CodeJhon/Kreacher-A-RISC-V-based-SoC-Design/2_Core/src/3_EX/divider_top.v

// =============================================================================
// File        : divider_top.v
// Author      : Jhon Steven Pinto Hernandez
// Email       : jhonstevenpintoh@gmail.com
// Description :
//   Implements signed/unsigned division and remainder operations with quick-result detection and pause signaling.
// =============================================================================

`include "../../include/CORE_CONSTANTS.vh"

module divider_top #(parameter XLEN = 64)(
    //Global
    input clk,
    input reset_n,
    input pause,

    //Operands & Operation Type
    input signed [XLEN-1:0]      opa,
    input signed [XLEN-1:0]      opb,
    input [5:0]                  sel_operation,

    //Output Flags
    output reg                   pause_to_divide,   

    //Result
    output reg signed [XLEN-1:0] remainder_result,
    output reg signed [XLEN-1:0] quotient_result
);

//Obtaining the lower part in the _W type instructions
reg signed [XLEN-1:0] dividend;
reg signed [XLEN-1:0] divisor;
always @( * ) begin
    case (sel_operation)
        `ALU_DIVW, `ALU_REMW: begin
            dividend = $signed(opa[31:0]);    // sign-extend
            divisor  = $signed(opb[31:0]);
        end
        `ALU_DIVUW, `ALU_REMUW: begin
            dividend = $unsigned(opa[31:0]);  // zero-extend
            divisor  = $unsigned(opb[31:0]);
        end
        default:begin
            dividend = opa;
            divisor  = opb;
        end
    endcase 
end

//Determining if operands are signed / unsigned -> Depending on the instruction
reg rs1_is_signed;
reg rs2_is_signed;
always @( * ) begin
    //Default values
    rs1_is_signed = 1'b0;
    rs2_is_signed = 1'b0;
    case (sel_operation)
        `ALU_DIV, `ALU_REM, `ALU_DIVW, `ALU_REMW:begin
            rs1_is_signed = 1'b1;
            rs2_is_signed = 1'b1;
        end
        `ALU_DIVU, `ALU_REMU, `ALU_DIVUW, `ALU_REMUW:begin //Unsigned
            rs1_is_signed = 1'b0;
            rs2_is_signed = 1'b0;
        end
    endcase
end

// Obtaining the absolute value of dividend & divisor -> For quick-result cases
wire a_neg = rs1_is_signed & dividend[XLEN-1];
wire b_neg = rs2_is_signed & divisor[XLEN-1];

wire  [XLEN-1:0] dividend_abs = a_neg ? (~dividend + 64'd1) : dividend;
wire  [XLEN-1:0] divisor_abs  = b_neg ? (~divisor  + 64'd1) : divisor;

//Quick-Result cases: Allow us to throw a result in the same cycle and not use the dedicated divider module
// Cases: Divide by zero, divisor greater than divider, divide by same number ...busy
reg flag_result_one;
reg flag_division_by_zero;
reg flag_result_zero;

wire flag_quick_result =    flag_result_one         |
                            flag_division_by_zero   |
                            flag_result_zero;

always @( * ) begin
    flag_division_by_zero  = 1'b0;
    flag_result_zero       = 1'b0;
    flag_result_one        = 1'b0;

    if(divisor == {XLEN{1'b0}})
        flag_division_by_zero = 1'b1;
    else if((dividend == {XLEN{1'b0}}) || (divisor_abs > dividend_abs))
        flag_result_zero      = 1'b1;
    else if(divisor_abs == dividend_abs)
        flag_result_one       = 1'b1;
end

//Start signal
reg start;
always @( * ) begin
    start = 1'b0;
    if(!flag_quick_result)begin
        case (sel_operation)
            `ALU_DIV   , `ALU_REM,
            `ALU_DIVU  , `ALU_REMU,
            `ALU_DIVW  , `ALU_REMW,
            `ALU_DIVUW , `ALU_REMUW:
                start = 1'b1;
        endcase
    end
end

//Module containing the division algorithm (radix 4) hardware
wire busy;
wire done;
wire signed [XLEN-1:0]  remainder;
wire signed [XLEN-1:0]  quotient;
radix_4_divider #(.XLEN(64)) radix_4_divider_inst (
    //Global
    .clk(clk),
    .reset_n(reset_n),
    .pause(pause),

    //Control
    .start(start),
    .rs1_is_signed(rs1_is_signed),
    .rs2_is_signed(rs2_is_signed),

    //Operands & Result
    .dividend($unsigned(dividend)),
    .divisor($unsigned(divisor)),

    .remainder(remainder),
    .quotient(quotient),

    //Output flags
    .busy(busy),
    .done(done)
);

//Output assignation

//Remainder result
always @( * ) begin
    //Default value
    remainder_result = remainder;

    //Quick-Result cases
    if(flag_division_by_zero)
            remainder_result = dividend;
    else if (flag_result_one)
            remainder_result = {XLEN{1'b0}};
    else if(flag_result_zero)
            remainder_result = dividend;
end

//Quotient result
wire instr_is_div_signed = (sel_operation == `ALU_DIV || sel_operation == `ALU_DIVW);
always @( * ) begin
    //Default value
    quotient_result = quotient;
    
    //------ Quick-Result cases-----

    //Division by zero
    if (flag_division_by_zero)
        quotient_result = {XLEN{1'b1}}; //Send FFFFFFFF_FFFFFFFF

    else if (flag_result_one)begin //Division by same magnitude
        if(dividend[XLEN-1] == divisor[XLEN-1]) // Same sign
            quotient_result = $signed(1);
        else
            quotient_result = $signed(-1); // Different sign
    end
    else if (flag_result_zero) // Division by 0 or by a/b (b>a)
            quotient_result = {XLEN{1'b0}};
end

//Pause signal
always @( * ) begin
    pause_to_divide = 1'b0;
    if(done)
        pause_to_divide = 1'b0;
    else if(start || busy)
        pause_to_divide = 1'b1;
end

endmodule
