CodeJhon/Kreacher-A-RISC-V-based-SoC-Design/3_Init_Memory_Controller/src/init_ctrl.v

// =============================================================================
// File        : init_ctrl.v
// Author      : Sanjai Palanisamy
// Email       : sanjai.palanisamy171@gmail.com
// Description :
//   This module implements the control FSM for memory initialization and normal memory 
// operations, managing address generation, instruction prefetch, and partial read/write 
// masking through appropriate control signals.
// =============================================================================

module init_ctrl #(
  parameter integer ADDR_W         = 17,         // PRAM address width
  parameter [ADDR_W-1:0] BASE_ADDR = 17'h00000,  // init start address
  parameter [ADDR_W-1:0] MEM_LIMIT = 17'h07FFF,   // MEM_LIMIT is an exclusive upper bound (init runs while addr < MEM_LIMIT)
  parameter [ADDR_W-1:0] INCR      = 17'd8
)(
  input  wire                 clk,
  input  wire                 reset_n,

  // -------------------------------------------------------------------------
  // Global control inputs
  // -------------------------------------------------------------------------
  input  wire                 interrupt,       // pause/abort during init
  input  wire                 enable,          // step address (one word)
  input  wire                 masking_enabled,
  input  wire                 partial_read_done,
  input  wire                 partial_write_done,

  // -------------------------------------------------------------------------
  // Encoded FSM state (visible to MemCtrl / top-level)
  // -------------------------------------------------------------------------
  output reg  [3:0]           state,           // 6-state encoding

  // -------------------------------------------------------------------------
  // Datapath control signals (match your control table)
  // -------------------------------------------------------------------------
  output reg  [1:0]           SPI_rdata_type,  // 0 = INITIALIZATION, 1 = EMBD_READ(load)
  output reg                  PRAM_addr_type,  // 0 = INITIALIZATION, 1 = LOAD/STORE ADDRESS
  output reg                  PRAM_in,         // 0 = INITIALIZATION, 1 = STORE DATA
  output reg                  burst_dim,       // 0 = INITIALIZATION, 1 = LOAD/STORE ADDRESS
  output reg                  ROM_addr_type,   // 0 = init read addr, 1 = EMAB(load/store)
  output reg                  mem_init,        // 1 = init phase (S_START/S_WAIT/S_PAUSE)
  output reg                  pre_fetch,
  output reg  [1:0]           write_enable_state,
  output reg                  write_state,
  // -------------------------------------------------------------------------
  // Address generated by internal counter
  // -------------------------------------------------------------------------
  output wire [ADDR_W-1:0]    INITIALIZATION_addr
);

  // -------------------------------------------------------------------------
  // Address counter instance
  // -------------------------------------------------------------------------
  wire [ADDR_W-1:0] count;
  reg mem_init_done;

  up_counter #(
    .INCR      (INCR),        // 8 bytes per word
    .LOAD_DIM  (ADDR_W),
    .COUNT_DIM (ADDR_W)
  ) up_counter_inst (
    .clk        (clk),
    .enable     (enable),
    .reset_n    (reset_n),
    .load_value (BASE_ADDR),
    .max_value  (MEM_LIMIT),
    .count      (count)
  );
  assign INITIALIZATION_addr = count;

  always @( * ) begin
  if (!reset_n)
    mem_init_done = 1'b0;
  else if (mem_init && enable && (INITIALIZATION_addr >= (MEM_LIMIT - INCR)))
    mem_init_done = 1'b1;
  else mem_init_done = 1'b0;
  end



  // -------------------------------------------------------------------------
  // FSM state encoding (4 states)
  // -------------------------------------------------------------------------
  localparam [3:0]
    S_IDLE               = 4'd0,  // after reset: go to S_START
    S_START              = 4'd1,  // first cycle of init
    S_WAIT               = 4'd2,  // wait for MemCtrl to finish
    S_FIRST_FETCH        = 4'd3,//to implement first fetch
    S_NORMAL_OP          = 4'd4,  // init success (terminal) and normal operation
    S_PARTIAL_READ       = 4'd5,
    S_APPLY_MASK         = 4'd6,
    S_PARTIAL_WRITE      = 4'd7,
    S_PARTIAL_STORE_DONE = 4'd8;

  reg [3:0] state_next;

  // ==========================================================================
  // State register
  // ==========================================================================
  always @(posedge clk, negedge reset_n) begin
    if (!reset_n)
      state <= S_IDLE;
    else
      state <= state_next;
  end

  // ==========================================================================
  // Next-state logic
  // ==========================================================================
  always @( * ) begin
    state_next = state;

    case (state)
      // After reset we always run external initialization
      S_IDLE: begin
        state_next = S_START;
      end

      // One init cycle, then wait for Memory Controller
      S_START: begin
        state_next = S_WAIT;
      end

      // Normal init in progress
      S_WAIT: begin
        if (mem_init_done || interrupt)
          state_next = S_FIRST_FETCH;
        else
          state_next = S_WAIT;
      end

      //first instruction fetch
      S_FIRST_FETCH: begin
        state_next = S_NORMAL_OP;
      end

      // Terminal states: stay here until global reset
      S_NORMAL_OP: begin
        if(masking_enabled)begin
          state_next = S_PARTIAL_READ;
        end
        else begin
          state_next = S_NORMAL_OP;
        end
      end

      S_PARTIAL_READ: begin
        if(partial_read_done)state_next = S_APPLY_MASK;
        else state_next = S_PARTIAL_READ;
      end

      S_APPLY_MASK: begin
        state_next = S_PARTIAL_WRITE;
      end
      
      S_PARTIAL_WRITE:begin
        //should add
        if(partial_write_done)  state_next = S_PARTIAL_STORE_DONE; 
        else state_next = S_PARTIAL_WRITE;
      end

      S_PARTIAL_STORE_DONE:begin
        state_next = S_NORMAL_OP;
      end
      default: state_next = S_IDLE;
    endcase
  end

  // ==========================================================================
  // Output control logic
  //   Default = load/store mode (green in your diagram).
  // ==========================================================================
  always @( * ) begin
    // ----- defaults: normal load/store mode -----
    mem_init       = 1'b0;
    SPI_rdata_type = 2'b01;   // 1 = EMBD_READ(load)
    PRAM_addr_type = 1'b1;   // 1 = LOAD/STORE address
    PRAM_in        = 1'b1;   // 1 = STORE data
    burst_dim      = 1'b1;   // 1 = LOAD/STORE
    ROM_addr_type  = 1'b1;   // 1 = EMAB(load/store address)
    pre_fetch    = 1'b0;
    write_enable_state = 2'b00;
    write_state    = 1'b0;

    case (state)
      // Initialization states
      S_START, S_WAIT : begin
        mem_init       = 1'b1;   // we are in init phase
        SPI_rdata_type = 2'b00;   // SPI data used for init
        PRAM_addr_type = 1'b0;   // address from init counter
        PRAM_in        = 1'b0;   // initialization data into PRAM
        burst_dim      = 1'b0;   // "initialization" mode
        ROM_addr_type  = 1'b0;   // ROM address from init counter
        pre_fetch    = 1'b0;
        write_enable_state    = 2'b01;
      end

      S_FIRST_FETCH : begin
        pre_fetch   = 1'b1;
      end
  
      S_PARTIAL_READ: begin
        write_enable_state = 2'b01;
        SPI_rdata_type = 2'b10;
      end

      S_APPLY_MASK:begin
        write_enable_state = 2'b01;
        burst_dim         = 1'b0;
      end

      S_PARTIAL_WRITE:begin
        write_enable_state    = 2'b10;// try to merge with 00
        write_state           = 1'b1;
      end

      S_PARTIAL_STORE_DONE:begin
        pre_fetch   = 1'b1;
      end
    endcase
  end

endmodule
