CodeJhon/Kreacher-A-RISC-V-based-SoC-Design/2_Core/src/1_IF_HK/IF_HK.v

// =============================================================================
// File        : IF_HK.v
// Author      : Jhon Steven Pinto Hernandez
// Email       : jhonstevenpintoh@gmail.com
// Description :
//   Combines instruction fetch and housekeeping logic for the IF/HK unit in the pipelined core.
// =============================================================================

`include "../../include/CORE_CONSTANTS.vh"

module IF_HK #(parameter XLEN = 64)(
    //Global
    input clk,
    input reset_n,
    input pause,
    
    //Special pause signal
    input EX_pause_request,

    //Interrupt Handler
    input take_interrupt_0,
    input take_interrupt_1,
    
    output [XLEN-1:0]      next_program_PC,
    output wire [XLEN-1:0] PC_step,
    
    //Buses
    input  [31:0]     EIB,  //External Instruction Bus
    output [16:0]     EIAB, //External Instruction Address Bus 

    //Control
    output            IF_pause_request,
    
    //----------------------------ID Stage
    //Data from/to ID stage
    input  [XLEN-1:0]     ID_exec_result,

    output reg [XLEN-1:0] ID_PC,
    output reg [XLEN-1:0] ID_PC_step,
    
    output reg [31:0]     ID_canonical_instruction,

    //Control from/to ID stage
    input                 ID_control_transfer_en,
    input                 ID_illegal_trap,

    //---------------------------- HCU (Hazard Control Unit)
    input                 IF_stall,
    input                 IF_stall_PC,
    input                 IF_flush

);

//--------------Internal to out
wire [XLEN-1:0] PC;

wire [31:0]     canonical_instruction;

// -> Internal core pause requested by IF_HK stage
wire            pause_to_concatenate; 

//------------Control 
wire pointer =  PC[1];
wire concatenate_in_next_cycle;
wire concatenate_flag;
wire instr_type;
wire sel_PC_step;

wire core_jump =    ID_control_transfer_en | 
                    take_interrupt_0       | 
                    take_interrupt_1       | 
                    ID_illegal_trap;

mini_controller u_mini_controller (
    // Global
    .clk                       (clk),
    .reset_n                   (reset_n),
    .pause                     (pause),

    // Quadrants of upper and lower halves of EIB
    .EIB_1_quad                (EIB[1:0]),
    .EIB_2_quad                (EIB[17:16]),

    .pointer                   (pointer),
    .core_jump                 (core_jump),

    // Control
    .concatenate_in_next_cycle (concatenate_in_next_cycle),
    .concatenate_flag          (concatenate_flag),
    .pause_to_concatenate      (pause_to_concatenate),

    .instr_type                (instr_type),
    .sel_PC_step               (sel_PC_step),
    
    //---------------------------- HCU (Hazard Control Unit)
    .stall(IF_stall),
    .flush(IF_flush)
);

fetch u_fetch (
    // Global
    .clk                       (clk),
    .reset_n                   (reset_n),
    .pause                     (pause),

    .EIB                       (EIB),

    .pointer                   (pointer),

    // Control
    .concatenate_in_next_cycle (concatenate_in_next_cycle),
    .concatenate_flag          (concatenate_flag),
    
    .instr_type                (instr_type),

    // Output
    .canonical_instruction     (canonical_instruction),

    //---------------------------- HCU (Hazard Control Unit)
    .stall(IF_stall),
    .flush(IF_flush)
);

housekeeping #(.XLEN(XLEN)) u_housekeeping (
    // Global
    .clk                (clk),
    .reset_n            (reset_n),
    .pause              (pause),

    //Special pause signal
    .EX_pause_request   (EX_pause_request),

    //Interrupt Handler
    .take_interrupt_0(take_interrupt_0),
    .take_interrupt_1(take_interrupt_1),

    // Control
    .control_transfer_en       (ID_control_transfer_en),
    .illegal_trap             (ID_illegal_trap),

    .concatenate_in_next_cycle (concatenate_in_next_cycle),
    .pause_to_concatenate      (pause_to_concatenate),

    .sel_PC_step               (sel_PC_step),

    // Addr coming from EX stage -> to jump at
    .exec_result               (ID_exec_result),

    // Outputs
    .EIAB                      (EIAB),                                     // ------> Connection to bus

    .PC                        (PC),
    .PC_step                   (PC_step),
    .next_program_PC           (next_program_PC),

    //---------------------------- HCU (Hazard Control Unit)
    .stall(IF_stall_PC)
    
);

// ------------------------------------- Connection to adjacent stage(s)

task clear_if_stage;
begin
    ID_PC                      <= {XLEN{1'd0}};
    ID_PC_step                 <= {XLEN{1'd0}};
    ID_canonical_instruction   <= 32'd0;
end
endtask

task write_if_stage;
begin
    ID_PC                      <= PC;
    ID_PC_step                 <= PC_step;
    ID_canonical_instruction   <= canonical_instruction;
end
endtask
//ID
always @(posedge clk, negedge reset_n) begin
    if(!reset_n)
        clear_if_stage;
    else if(!pause && !IF_stall && !pause_to_concatenate)begin
        if (IF_flush)
            clear_if_stage;
        else
            write_if_stage;
    end 
end



// -------------------------------------- Other connections

//Control
assign IF_pause_request = pause_to_concatenate;

endmodule
