CodeJhon/Kreacher-A-RISC-V-based-SoC-Design/2_Core/src/4_MEM/MEM.v

// =============================================================================
// File        : MEM.v
// Author      : Jhon Steven Pinto Hernandez
// Email       : jhonstevenpintoh@gmail.com
// Description :
//   Handles memory stage data path, external memory bus interface, and forwarding between MEM and WB stages.
// =============================================================================

`include "../../include/CORE_CONSTANTS.vh"

module MEM #(parameter XLEN = 64)(
    //Global
    input clk,
    input reset_n,
    input pause,

    //Buses
    output [XLEN-1:0]     EMAB,            //External Memory Address Bus
    output                EMCB,            //External Memory Control Bus
    output [XLEN-1:0]     EMCB_mask,       //External Memory Control Bus -> Bit Mask
    input  [XLEN-1:0]     EMDB_in,            //External Memory Input Data Bus
    output [XLEN-1:0]     EMDB_out,          //External Memory Output Data Bus

    //----------------------------EX Stage
    //Data from/to EX stage
    input [XLEN-1:0]      EX_PC_step,
    input [XLEN-1:0]      EX_exec_result,
    input [XLEN-1:0]      EX_RS2,
    input [4:0]           EX_RD_addr_in,
    input [XLEN-1:0]      EX_csr_data_rd,
    input [11:0]          EX_csr_addr_wr_in,
    
    output [XLEN-1:0]     EX_RD,
    output [4:0]          EX_RD_addr_out,
    output [XLEN-1:0]     EX_FW_exec_result,
    output [XLEN-1:0]     EX_csr_data_wr,
    output [11:0]         EX_csr_addr_wr_out,

    //Control from/to EX stage
    input                 EX_mem_wr_en,
    input [2:0]           EX_val_rd_type,
    input [2:0]           EX_val_wr_type,
    input                 EX_result_type,
    input                 EX_csr_we_in,
    
    input                 EX_regfile_we_in,
    
    input [2:0]           EX_sel_writeback,

    output                EX_regfile_we_out,
    output                EX_csr_we_out,

    //----------------------------WB Stage
    //Data from/to WB stage
    input [XLEN-1:0]      WB_RD,
    input [4:0]           WB_RD_addr_in,
    input [XLEN-1:0]      WB_csr_data_wr,
    input [11:0]          WB_csr_addr_wr_in,

    output reg [XLEN-1:0] WB_PC_step,
    output reg [XLEN-1:0] WB_exec_result,
    output reg [XLEN-1:0] WB_EMDB,
    output reg [4:0]      WB_RD_addr_out,
    output reg [XLEN-1:0] WB_csr_data_rd,
    output reg [11:0]     WB_csr_addr_wr_out,

    //Control from/to WB stage
    input                 WB_regfile_we_in,
    input                 WB_csr_we_in,

    output reg            WB_regfile_we_out,
    output reg            WB_csr_we_out,
    output reg [2:0]      WB_sel_writeback    

);


// ---------------------------------- Implementation of modules

wire [XLEN-1:0] bit_mask;
extension_wr #(.XLEN(XLEN)) extend_write (
    .extend_in(EX_RS2),
    .extend_out(EMDB_out),
    .bit_mask(bit_mask),
    .extension_type(EX_val_wr_type),
    .extension_start_addr(EX_exec_result[1:0])
);

wire [XLEN-1:0] EMDB_in_extended;
extension_rd #(.XLEN(XLEN)) extend_read (
    .extend_in(EMDB_in),
    .extend_out(EMDB_in_extended),
    .extension_type(EX_val_rd_type),
    .extension_start_addr(EX_exec_result[2:0])
);

wire[XLEN-1:0] exec_result;
extension_exec_result #(.XLEN(XLEN)) extend_result (
    .extend_in(EX_exec_result),
    .extend_out(exec_result),
    .extension_type(EX_result_type)
);


// ------------------------------------- Connection to adjacent stage(s)
//EX
assign EX_RD                = WB_RD;
assign EX_RD_addr_out       = WB_RD_addr_in;
assign EX_FW_exec_result        = EX_exec_result;
assign EX_regfile_we_out    = WB_regfile_we_in;
assign EX_csr_we_out        = WB_csr_we_in;
assign EX_csr_data_wr       = WB_csr_data_wr;
assign EX_csr_addr_wr_out   = WB_csr_addr_wr_in;

task clear_mem_stage;
begin
    WB_PC_step           <= {XLEN{1'd0}};
    WB_exec_result       <= {XLEN{1'd0}};
    WB_EMDB              <= {XLEN{1'd0}};
    WB_RD_addr_out       <= 5'd0;

    WB_regfile_we_out    <= 1'd0;
    WB_sel_writeback     <= 3'd0;
    WB_csr_we_out        <= 1'd0;
    WB_csr_data_rd       <= {XLEN{1'd0}};
    WB_csr_addr_wr_out   <= 12'd0;
end
endtask

task write_mem_stage;
begin
    WB_PC_step              <= EX_PC_step;
    WB_exec_result       <= exec_result;
    WB_EMDB              <= EMDB_in_extended;
    WB_RD_addr_out       <= EX_RD_addr_in;

    WB_regfile_we_out    <= EX_regfile_we_in;
    WB_sel_writeback     <= EX_sel_writeback;
    WB_csr_we_out        <= EX_csr_we_in;
    WB_csr_data_rd       <= EX_csr_data_rd;
    WB_csr_addr_wr_out   <= EX_csr_addr_wr_in;
end
endtask

//WB
always @(posedge clk, negedge reset_n) begin
    if(!reset_n)
        clear_mem_stage;
    else if(!pause)
        write_mem_stage;
end


// -------------------------------------- Connection to buses (if any)
assign EMAB                 = EX_exec_result;
assign EMCB                 = EX_mem_wr_en;
assign EMCB_mask            = bit_mask;

endmodule
