CodeJhon/Kreacher-A-RISC-V-based-SoC-Design/0_Verification/verification_commits.v

module verification_commits  #(parameter XLEN = 32)(
    //Global
    input clk,
    input reset_n,

    //pause signals
    input pause_ID,
    input pause_EX,
    input pause_MEM,
    
    //Signals retrieved from the core
    input [XLEN-1:0]    IF_PC,
    input [31:0]        IF_canonical_instruction,

    input               WB_regfile_we,
    input               WB_csr_we,
    input [4:0]         WB_RD_addr,
    input [XLEN-1:0]    WB_RD,
    input [11:0]        WB_csr_addr,
    input [XLEN-1:0]    WB_csr,

    //Outputs used for the framework
    output              commit_valid,
    output              commit_csr_valid,
    output [XLEN-1:0]   commit_PC,
    output [4:0]        commit_rd_addr,
    output [XLEN-1:0]   commit_rd_value,
    output [11:0]       commit_csr_addr,
    output [XLEN-1:0]   commit_csr_value,
    output [31:0]       commit_instruction,

    //HCU flush signals (for better visualization when flushing happen)
    // IF_flush is already implicit within IF_PC
    input               ID_flush,
    input               EX_flush

);

//--------------------------Creation of new signals for non-WB stages
    //PC
reg [XLEN-1:0] ID_PC_EX;
reg [XLEN-1:0] EX_PC_MEM;
reg [XLEN-1:0] MEM_PC_WB;

always @(posedge clk, negedge reset_n) begin
    if(!reset_n) begin        
        ID_PC_EX  <= 0;
        EX_PC_MEM <= 0;
        MEM_PC_WB <= 0;
    end
    
    else begin
        
        if(!pause_ID)begin
            if(ID_flush)
                ID_PC_EX  <= 0;
            else
                ID_PC_EX  <= IF_PC;
        end 
        
        if(!pause_EX)begin
            if(EX_flush)
                EX_PC_MEM <= 0;
            else
                EX_PC_MEM <= ID_PC_EX;
        end 
        
        if(!pause_MEM) MEM_PC_WB <= EX_PC_MEM;
    end
end

    //canonical_instruction
reg [31:0] ID_canonical_instruction_EX;
reg [31:0] EX_canonical_instruction_MEM;
reg [31:0] MEM_canonical_instruction_WB;

always @(posedge clk, negedge reset_n) begin
    if(!reset_n) begin
        ID_canonical_instruction_EX  <= 0;
        EX_canonical_instruction_MEM <= 0;
        MEM_canonical_instruction_WB <= 0;        
    end
    else begin
        if(!pause_ID)begin
            if(ID_flush)
                ID_canonical_instruction_EX  <= 0;
            else 
                ID_canonical_instruction_EX  <= IF_canonical_instruction;
        end
        
        if(!pause_EX)begin
            if(EX_flush)
                EX_canonical_instruction_MEM  <= 0;
            else
                EX_canonical_instruction_MEM <= ID_canonical_instruction_EX;
        end 
        
        if(!pause_MEM) MEM_canonical_instruction_WB <= EX_canonical_instruction_MEM;    
    end
end

//----------------------------Assignation of signals present in WB stage

assign commit_valid       = WB_regfile_we;
assign commit_PC          = MEM_PC_WB;
assign commit_rd_addr     = WB_RD_addr;
assign commit_rd_value    = WB_RD;
assign commit_instruction = MEM_canonical_instruction_WB;

//----------------------------Assignation of signals related to CSR commits
assign commit_csr_valid     = WB_csr_we;
assign commit_csr_addr      = WB_csr_addr;
assign commit_csr_value     = WB_csr;

endmodule
