CodeJhon/Kreacher-A-RISC-V-based-SoC-Design/Memories/src/aes128_test.c

#include <stdint.h>

#if defined(__riscv)
#include "corelib.h"
__attribute__((section(".exit_value")))
volatile uint32_t exit_value;
#else
#include <stdio.h>
#endif

static const uint8_t sbox[256] = {
    0x63,0x7c,0x77,0x7b,0xf2,0x6b,0x6f,0xc5,0x30,0x01,0x67,0x2b,0xfe,0xd7,0xab,0x76,
    0xca,0x82,0xc9,0x7d,0xfa,0x59,0x47,0xf0,0xad,0xd4,0xa2,0xaf,0x9c,0xa4,0x72,0xc0,
    0xb7,0xfd,0x93,0x26,0x36,0x3f,0xf7,0xcc,0x34,0xa5,0xe5,0xf1,0x71,0xd8,0x31,0x15,
    0x04,0xc7,0x23,0xc3,0x18,0x96,0x05,0x9a,0x07,0x12,0x80,0xe2,0xeb,0x27,0xb2,0x75,
    0x09,0x83,0x2c,0x1a,0x1b,0x6e,0x5a,0xa0,0x52,0x3b,0xd6,0xb3,0x29,0xe3,0x2f,0x84,
    0x53,0xd1,0x00,0xed,0x20,0xfc,0xb1,0x5b,0x6a,0xcb,0xbe,0x39,0x4a,0x4c,0x58,0xcf,
    0xd0,0xef,0xaa,0xfb,0x43,0x4d,0x33,0x85,0x45,0xf9,0x02,0x7f,0x50,0x3c,0x9f,0xa8,
    0x51,0xa3,0x40,0x8f,0x92,0x9d,0x38,0xf5,0xbc,0xb6,0xda,0x21,0x10,0xff,0xf3,0xd2,
    0xcd,0x0c,0x13,0xec,0x5f,0x97,0x44,0x17,0xc4,0xa7,0x7e,0x3d,0x64,0x5d,0x19,0x73,
    0x60,0x81,0x4f,0xdc,0x22,0x2a,0x90,0x88,0x46,0xee,0xb8,0x14,0xde,0x5e,0x0b,0xdb,
    0xe0,0x32,0x3a,0x0a,0x49,0x06,0x24,0x5c,0xc2,0xd3,0xac,0x62,0x91,0x95,0xe4,0x79,
    0xe7,0xc8,0x37,0x6d,0x8d,0xd5,0x4e,0xa9,0x6c,0x56,0xf4,0xea,0x65,0x7a,0xae,0x08,
    0xba,0x78,0x25,0x2e,0x1c,0xa6,0xb4,0xc6,0xe8,0xdd,0x74,0x1f,0x4b,0xbd,0x8b,0x8a,
    0x70,0x3e,0xb5,0x66,0x48,0x03,0xf6,0x0e,0x61,0x35,0x57,0xb9,0x86,0xc1,0x1d,0x9e,
    0xe1,0xf8,0x98,0x11,0x69,0xd9,0x8e,0x94,0x9b,0x1e,0x87,0xe9,0xce,0x55,0x28,0xdf,
    0x8c,0xa1,0x89,0x0d,0xbf,0xe6,0x42,0x68,0x41,0x99,0x2d,0x0f,0xb0,0x54,0xbb,0x16
};

static const uint8_t rcon[10] = {0x01,0x02,0x04,0x08,0x10,0x20,0x40,0x80,0x1B,0x36};

static inline uint8_t xtime(uint8_t x) { return (uint8_t)((x << 1) ^ ((x & 0x80u) ? 0x1bu : 0)); }
static inline uint8_t mul2(uint8_t x) { return xtime(x); }
static inline uint8_t mul3(uint8_t x) { return (uint8_t)(xtime(x) ^ x); }

static void sub_bytes(uint8_t st[16]) { for (uint32_t i = 0; i < 16; i++) st[i] = sbox[st[i]]; }

static void shift_rows(uint8_t st[16]) {
    uint8_t t;
    t = st[1];  st[1]  = st[5];  st[5]  = st[9];  st[9]  = st[13]; st[13] = t;
    t = st[2];  st[2]  = st[10]; st[10] = t;
    t = st[6];  st[6]  = st[14]; st[14] = t;
    t = st[15]; st[15] = st[11]; st[11] = st[7];  st[7]  = st[3];  st[3]  = t;
}

static void mix_columns(uint8_t st[16]) {
    for (uint32_t c = 0; c < 4; c++) {
        uint32_t i = c * 4;
        uint8_t a0 = st[i+0], a1 = st[i+1], a2 = st[i+2], a3 = st[i+3];
        st[i+0] = (uint8_t)(mul2(a0) ^ mul3(a1) ^ a2 ^ a3);
        st[i+1] = (uint8_t)(a0 ^ mul2(a1) ^ mul3(a2) ^ a3);
        st[i+2] = (uint8_t)(a0 ^ a1 ^ mul2(a2) ^ mul3(a3));
        st[i+3] = (uint8_t)(mul3(a0) ^ a1 ^ a2 ^ mul2(a3));
    }
}

static void add_round_key(uint8_t st[16], const uint8_t *rk) {
    for (uint32_t i = 0; i < 16; i++) st[i] ^= rk[i];
}

static void key_expansion(const uint8_t key[16], uint8_t round_keys[176]) {
    for (uint32_t i = 0; i < 16; i++) round_keys[i] = key[i];

    uint32_t bytes_generated = 16, rcon_idx = 0;
    uint8_t temp[4];

    while (bytes_generated < 176) {
        for (uint32_t i = 0; i < 4; i++) temp[i] = round_keys[bytes_generated - 4 + i];

        if ((bytes_generated & 15u) == 0) {
            uint8_t t = temp[0];
            temp[0] = sbox[temp[1]] ^ rcon[rcon_idx++];
            temp[1] = sbox[temp[2]];
            temp[2] = sbox[temp[3]];
            temp[3] = sbox[t];
        }

        for (uint32_t i = 0; i < 4; i++) {
            round_keys[bytes_generated] = round_keys[bytes_generated - 16] ^ temp[i];
            bytes_generated++;
        }
    }
}

static void aes128_encrypt_block(uint8_t st[16], const uint8_t round_keys[176]) {
    add_round_key(st, &round_keys[0]);
    for (uint32_t round = 1; round <= 9; round++) {
        sub_bytes(st);
        shift_rows(st);
        mix_columns(st);
        add_round_key(st, &round_keys[round * 16]);
    }
    sub_bytes(st);
    shift_rows(st);
    add_round_key(st, &round_keys[160]);
}

static uint32_t signature_test(void) {
    static uint8_t key[16], pt[16], st[16], round_keys[176];

    for (uint32_t i = 0; i < 16; i++) {
        key[i] = (uint8_t)(i * 17u + 3u);
        pt[i]  = (uint8_t)(i * 29u + 11u);
        st[i]  = pt[i];
    }

    key_expansion(key, round_keys);
    aes128_encrypt_block(st, round_keys);

#if !defined(__riscv)
    printf("AES-128 ciphertext:\n");
    for (uint32_t i = 0; i < 16; i++) {
        printf("%02x", st[i]);
        if ((i & 3u) == 3u) printf(" ");
    }
    printf("\n");
#endif

    uint64_t acc = 0x510e527fade682d1ULL;
    for (uint32_t i = 0; i < 176; i++) {
        acc ^= (uint64_t)round_keys[i];
        acc += ((uint64_t)round_keys[i] << (i & 7u));
    }
    for (uint32_t i = 0; i < 16; i++) {
        acc ^= (uint64_t)st[i];
        if (st[i] & 1u) acc ^= 0x1111u;
        else            acc += 0x2222u;

        switch (i & 3u) {
            case 0: acc += 0x11111111ULL; break;
            case 1: acc ^= 0x22222222ULL; break;
            case 2: acc -= 0x33333333ULL; break;
            default: acc ^= (acc >> 5);   break;
        }
    }

    return (uint32_t)(acc ^ (acc >> 32));
}

int main(void) {
    uint32_t sig = signature_test();

#if defined(__riscv)
    exit_value = sig;
#else
    printf("aes128_signature=0x%08x\n", sig);
    //aes128_signature=0xc063dcde
#endif

    return (int)sig;
}
