CodeJhon/Kreacher-A-RISC-V-based-SoC-Design/(commit log)

2025-10-31 Added first test files and gitignore for skipping vivado project folder
    [ALU.v, ALU_tb.v]
2025-11-05 Finished first version of Execution Unit. Next step: Make a testbench to check the correct functionality of it
    [ALU.v]
2025-11-05 Changes made for correct include statement
    [ALU.v, ALU_tb.v]
2025-11-05 Added tb and fixed problem when simulated due to localparam usage
    [ALU.v]
2025-11-09 Finished circuit of regbank. Pending to coupling into datapath
2025-11-09 Modules coupled to datapath
2025-11-16 Addition of execute stage
2025-11-16 Added first files of MEM stage. Pending to resolve situation with sharing 1 bus for data (resolve with James)
    [IF_HK.v, MEM.v, sign_extension.v]
2025-11-16 Added first files of WB stage
2025-11-16 insertion of data signals
2025-11-18 Added sign-extension functionality for MEM stage
2025-11-18 New memory additions (not working yet)
    [RAM.v, mock_memories_tb.v]
2025-11-18 Organized memory files, connected and proved testbench with ADDI and debugged problem regading muxes
    [EX.v, IF_HK.v, RAM.v, WB.v, kreacher_top.v, mock_memories_tb.v, regfile.v]
2025-11-19 Add instructions in PMEM for test of core. Corresponding assembly code in text added
2025-11-19 Add assembly instruction file
2025-11-20 Pipelined IF_HK stage
2025-11-20 Changed synchronous reset with asynchronous reset
    [IF_HK.v, RAM.v, regfile.v]
2025-11-20 Added proper wire treatment in ID stage for future pipelining
2025-11-20 Accommodated signals of EX stage
2025-11-20 Added proper wire treatment in MEM stage for future pipelining
2025-11-20 Fixed line formatting for better readibility
    [EX.v, ID.v, IF_HK.v, MEM.v, WB.v, control.v, extend_imm.v, regfile.v]
2025-11-20 Pipelined ID stage
2025-11-20 Pipelined EX stage
2025-11-20 Pipelined MEM stage
2025-11-20 Modified ROM and RAM following the principle: In a single cycle processor, you should avoid having your RAM/ROM read in more than half a cycle
    [RAM.v]
2025-11-20 Discarded RAM/ROM modifications since this problem is not present in pipelined architectures
    [RAM.v]
2025-11-20 Added missing parts of last commit
    [ID.v, core.v]
2025-11-20 Sign_extension update of the code mistake
    [sign_extension.v]
2025-11-20 Debugged EX circuit
2025-11-20 Debugged architecture for correct RAW handling in HCU
    [EX.v, HCU.v, core.v]
2025-11-21 Changed regfile to avoid doing writes to X0
    [regfile.v]
2025-11-21 Reverted wrongly pipelined IF stage into single cycle core
    [IF_HK.v, regfile.v]
2025-11-21 Kept IF_HK pipeline stage for Pipelined Core
2025-11-21 Added missing signal in sensitivity list
    [sign_extension.v]
2025-11-22 Fixed HCU missing ports and tb cycles
    [core.v]
2025-11-22 Added first connections to HCU to implement Stalls/Flushes
    [HCU.v, ID.v, IF_HK.v, core.v]
2025-11-22 Implemented HCU extension for stalling when having Data hazards due to LW instruction
    [HCU.v]
2025-11-24 Fixed case typo: next_pc -> next_PC
    [ID.v, control.v]
2025-11-24 Added image for better schematic version tracking
2025-12-09 Added missing lines from verification
    [ALU.v, MEM.v, WB.v]
2025-12-10 Fixed typo in length
    [verification_commits.v]
2025-12-13 New files for tesing and updated verification scripts for correct comparison
    [core_tb.sv]
2025-12-19 A more comprehensive RV64I test
    On branch master
    Your branch is behind 'origin/master' by 5 commits, and can be fast-forwarded.
    (use "git pull" to update your local branch)
    Changes to be committed:
    modified: 3_Verification/auto_test/PMEM_instructions.txt
    modified: 3_Verification/auto_test/linker.ld
    modified: 3_Verification/auto_test/simulation_reference.log
    modified: Memory/src/PMEM_content.mem
    You are currently rebasing branch 'master' on '257f5e8'.
    Changes to be committed:
    modified: 3_Verification/auto_test/PMEM_instructions.txt
    modified: 3_Verification/auto_test/linker.ld
    modified: 3_Verification/auto_test/simulation_reference.log#
    modified: Memory/src/PME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
2026-01-07 Replacement of mask logic (unreliable for HW) to a internal pause generated by a synchronized reset
    [EX.v, ID.v, IF_HK.v, MEM.v, core.v, fetch.v, housekeeping.v, mini_controller.v]
2026-01-08 HAL Fixes Single Cycle Core 2.1 -> Also with respective changes to Pipelined Core 2.1
    [ALU.v, EX.v, ID.v, IF_HK.v, MEM.v, RAM.v, WB.v, build_imm.v]
2026-01-12 Changing verification framework to have verification_commits connected in tb
2026-01-12 fixed typo in testbench
    [core_tb.sv]
2026-01-12 Deleted file in wrong location
    [verification_commits.v]
2026-01-12 Fixed wrong usage of pause_to_concatenate for IF pipeline stage
    [IF_HK.v]
2026-02-07 Core fix: Send to_EIAB_old when having an (internal) pause request
    [housekeeping.v]
2026-02-10 System: Full RV64IMC + All macros + Interrupts
2026-02-11 Insertion of Pads into kreacher_top & fixing SPI slave for mocking delay
    [RAM.v, kreacher_top.v, spi_slave_interface.v]
2026-02-11 Strengthening Wrapper tb by proper assertion/deassertion of interrupts -> Half-Cycle latency based
    [wrapper_tb.sv]
2026-02-12 Core & System fixes for 1st functional Physical Implementation version
    - Fix -> Moved logic for valid_instr_fetch inside the pause handler and re-used external valid_instr fetch inside the memory controller
    - Strengthen logic -> Always pause at least 1 cycle when doing internal loads
    - Fixes in system -> Don't fetch when scheduling, and usage of tick_for_internal_load
    - Core fixes to avoid combinational loops
    - System fixes to avoid combinational loops
    ---- Specific changes for the pipelined core ---
    - Sending IF_stall ID_flush to 0 in case of pause signal and puting valid_instr_fetch to 0 when IF_stall_PC
    - Fixed combinational timing loop caused by HCU
    [EX.v, HCU.v, ID.v, IF_HK.v, Memory_controller.v, PMEM_interface.v, control.v, core.v]
2026-03-14 Verification of remaining 2.3 features (Interrupts, Illegal Instructions, Zicsr)
2026-04-13 Add .gitattributes to exclude assembly files from language statistics
